7757/fanduck/assets/wechat-group-qr-20260922.png

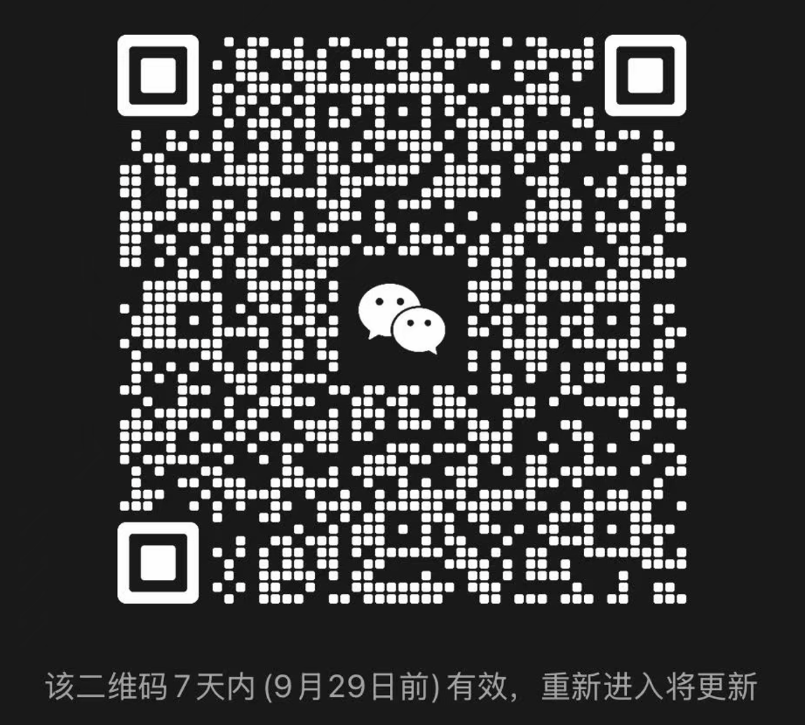
assets/wechat-group-qr-20260922.png
