7757/fanduck/hardware/dchub-v1.1/review/3D_bottom_iso.png

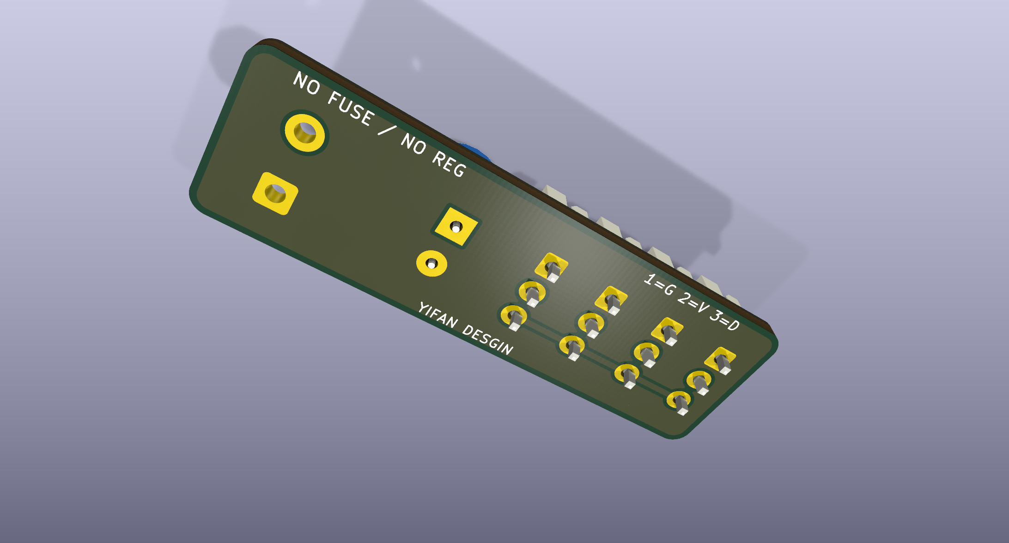
hardware/dchub-v1.1/review/3D_bottom_iso.png
