7757/fanduck/hardware/dchub-v1.1/review/3D_top_orthographic.png

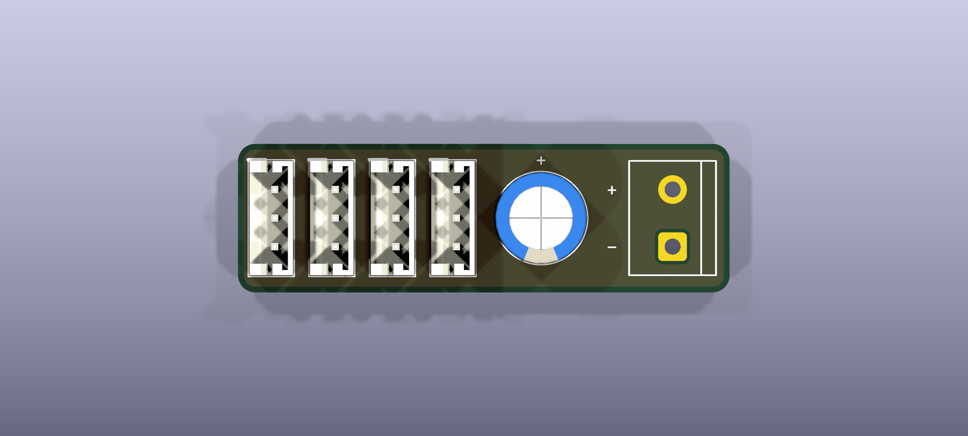
hardware/dchub-v1.1/review/3D_top_orthographic.png
