7757/fanduck/hardware/dchub-v1.1/source/BOM_manual_assembly.csv

References | Qty | Category | Manufacturer | MPN / specification | Value | Footprint | Assembly | Evidence status | Notes
J1,J2,J3,J4 | 4 | X3P connector | JST | B3B-EH-A(LF)(SN) | 3-pin EH, 2.50 mm | DCHUB:JST_EH_B3B-EH-A_1x03_P2.50mm_Vertical_Rot90 | Manual THT | Manufacturer confirmed | JST rates EH at 3 A AC/DC with AWG22; each installed branch still requires load verification.
J5 | 1 | Battery terminal | Generic / owner-specified | KF301-5.0-2P | 2-pin, 5.00 mm pitch | DCHUB:KF301-5.0-2P | Manual THT | Third-party / verify purchased part | Body <=7.6 x 10.0 mm, lead diameter <=1.3 mm. Verify exact supplier drawing before soldering.
C1 | 1 | Bulk capacitor | Panasonic | EEU-FR1C471 | 470 uF, 16 V, 105 C | DCHUB:CP_Radial_D8.0mm_P3.50mm_Vertical | Manual THT | Manufacturer confirmed | Polarized; 8.0 x 11.5 mm, P3.5 mm, FR low-impedance series.
