7757/fanduck/downloads/dchub-v1.1-20261030/fanduck-dchub-v1.1-schematic.pdf

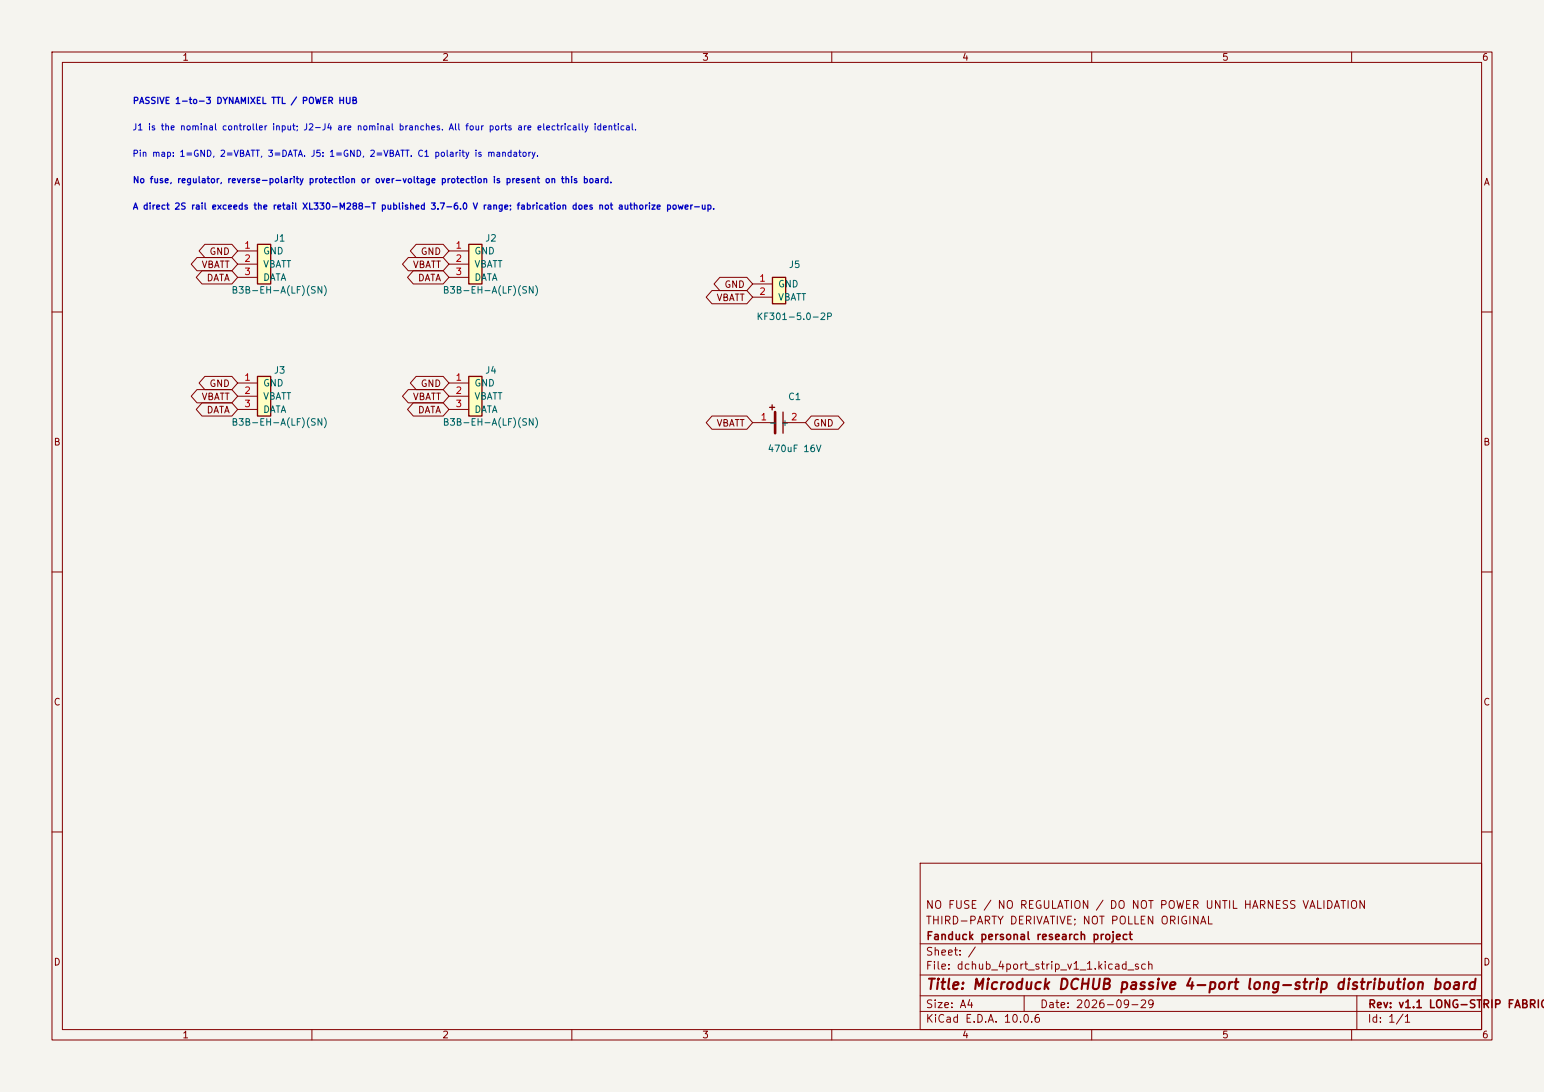
[picture p9: page 1]

VBATT PASSIVE 1-to-3 DYNAMIXEL TTL / POWER HUB

J1 is the nominal controller input; J2-J4 are nominal branches. All four ports are electrically identical. Pin map: 1=GND, 2=VBATT, 3=DATA. J5: 1=GND, 2=VBATT. C1 polarity is mandatory. No fuse, regulator, reverse-polarity protection or over-voltage protection is present on this board. A direct 2S rail exceeds the retail XL330-M288-T published 3.7-6.0 V range; fabrication does not authorize power-up.

J3 B3B-EH-A(LF)(SN) GND 1
VBATT DATA GND

J4 B3B-EH-A(LF)(SN) VBATT GND

NO FUSE / NO REGULATION / DO NOT POWER UNTIL HARNESS VALIDATION
THIRD-PARTY DERIVATIVE; NOT POLLEN ORIGINAL
Fanduck personal research project
Sheet: /
File: dchub_4port_strip_v1_1.kicad_sch
Title: Microduck DCHUB passive 4-port long-strip distribution board
KiCad E.D.A. 10.0.6
