7757/fanduck/hardware/dchub-v1.1/review/Drill_map.pdf

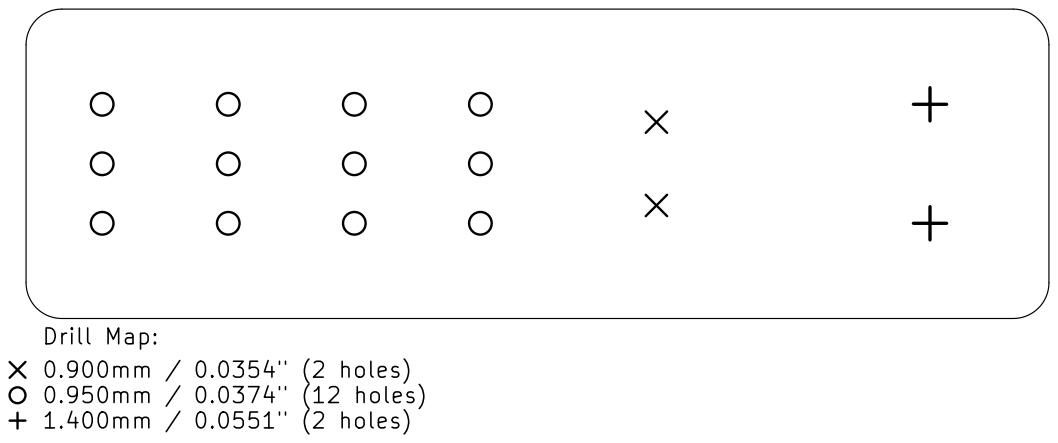
[picture p10: page 1]
