7757/fanduck/hardware/dchub-v1.1/review/PCB_bottom_mirrored.pdf

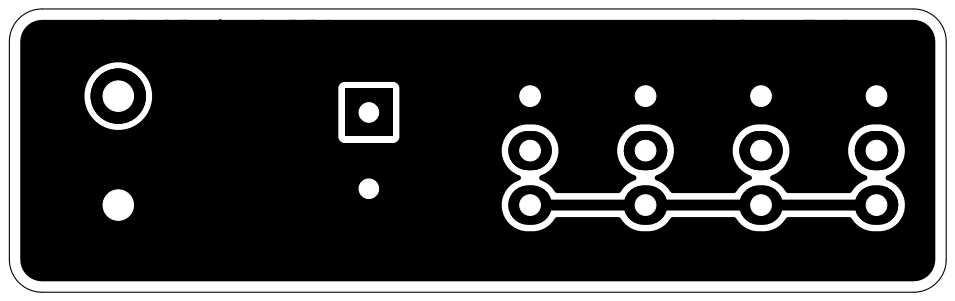
[picture p11: page 1]
