7757/fanduck/hardware/dchub-v1.1/review/PCB_top.pdf

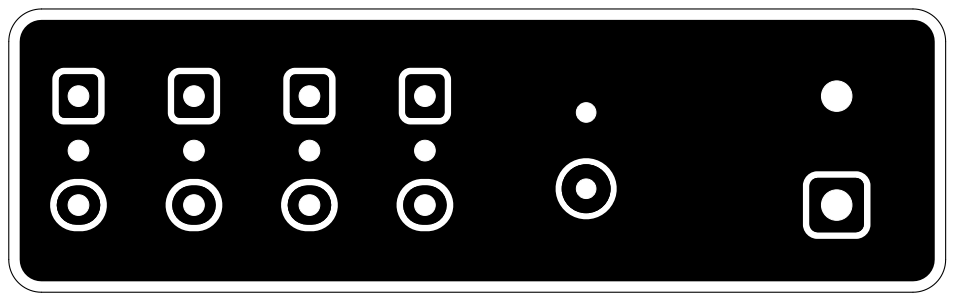
[picture p12: page 1]
