7757/fanduck/hardware/dchub-v1.1/source/dchub_4port_strip_v1_1.kicad_pcb

## KiCad design hardware/dchub-v1.1/source/dchub_4port_strip_v1_1.kicad_pcb (2026-10-30)

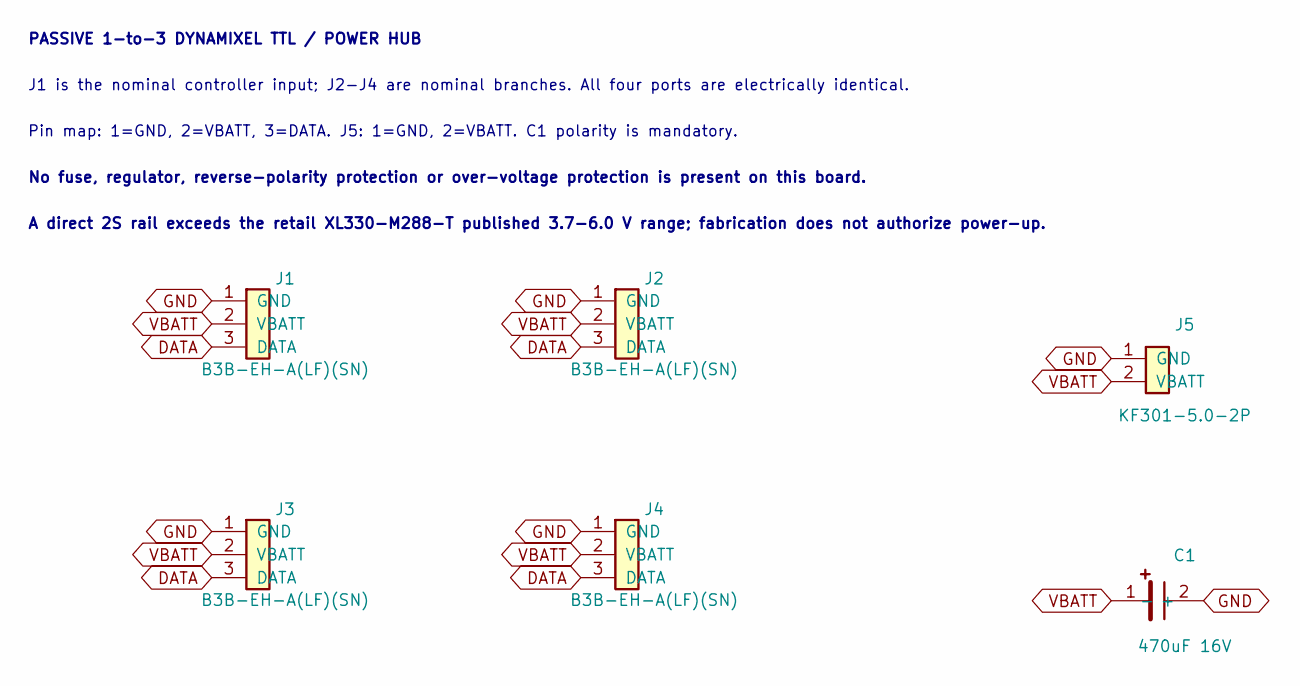
[picture p13: schematic dchub_4port_strip_v1_1.kicad_sch, Microduck DCHUB passive 4-port long-strip distribution board]

Parts:
C1: 470uF 16V; CP_Radial_D8.0mm_P3.50mm_Vertical
J1, J2, J3, J4: B3B-EH-A(LF)(SN); JST_EH_B3B-EH-A_1x03_P2.50mm_Vertical_Rot90
J5: KF301-5.0-2P

Connections:
DATA: J1.3 (DATA), J2.3 (DATA), J3.3 (DATA), J4.3 (DATA)
GND: C1.2 (-), J1.1 (GND), J2.1 (GND), J3.1 (GND), J4.1 (GND), J5.1 (GND)
VBATT: C1.1 (+), J1.2 (VBATT), J2.2 (VBATT), J3.2 (VBATT), J4.2 (VBATT), J5.2 (VBATT)

Notes on the sheet:
PASSIVE 1-to-3 DYNAMIXEL TTL / POWER HUB
J1 is the nominal controller input; J2-J4 are nominal branches. All four ports are electrically identical.
Pin map: 1=GND, 2=VBATT, 3=DATA. J5: 1=GND, 2=VBATT. C1 polarity is mandatory.
No fuse, regulator, reverse-polarity protection or over-voltage protection is present on this board.
A direct 2S rail exceeds the retail XL330-M288-T published 3.7-6.0 V range; fabrication does not authorize power-up.

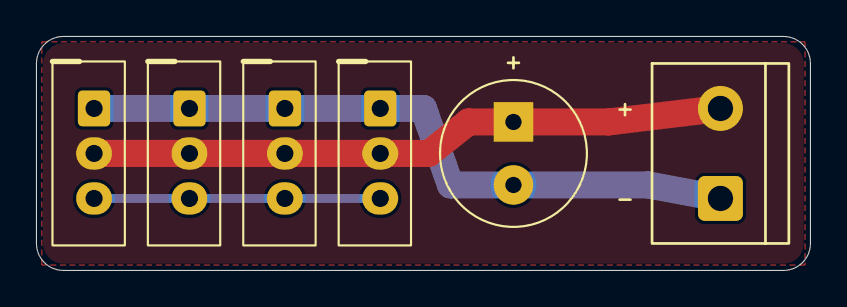
[picture p14: board dchub_4port_strip_v1_1.kicad_pcb from above]

Board: 2 copper layers, 43.0 x 13.0 mm, 6 parts (0 on the bottom side), 3 nets.
