7757/fanduck/hardware/dchub-v1.1/manufacturing/pcba/PCBA_ASSEMBLY_NOTES.md

# DCHUB 4P LONG v1.1 — 嘉立创 PCBA 插件装配说明

## 装配范围

- 仅顶层装配，共 6 个器件、16 个插件焊点／片。
- J1–J4：原厂 JST `B3B-EH-A(LF)(SN)`，嘉立创编号 `C160259`，每片 4 个。
- J5：KEFA `KF301-5.0-2P`，嘉立创编号 `C474881`，每片 1 个。
- C1：Rubycon `16ZLH470MEFC8X11.5`，470 uF / 16 V，嘉立创编号 `C109066`，每片 1 个。

## 方向要求

1. J1–J4 必须同向安装，不得任意旋转 180°。1 脚对准 PCB 方形焊盘；从板顶边到板底边依次为 1=GND、2=VBATT、3=DATA。
2. C1 是有极性电解电容。正极安装到 C1.1 方形焊盘以及 PCB `+` 丝印一侧；负极安装到 C1.2 与 `-` 丝印一侧。反装不得出货。
3. J5 的 2 脚为 VBATT 正极，位于 PCB `+` 丝印一侧；1 脚为 GND，位于 `-` 丝印一侧。接线开口朝向 PCB 右侧外边缘。
4. 所有器件必须贴紧 PCB、保持竖直；J1–J4 的塑壳底面高度和方向应一致。

## 文件说明

- `JLCPCB_BOM_DCHUB_4P_LONG_v1.1.csv`：带列名的完整 BOM，已固定嘉立创器件编号。
- `JLCPCB_BOM_UPLOAD_DCHUB_4P_LONG_v1.1.csv`：嘉立创网页实际上传版。当前“AD、99SE、Allegro、PADS 等其他”解析器会把普通 CSV 列名误当成一个器件，因此该文件按平台实际解析行为去掉列名，只保留三行有效物料。
- `JLCPCB_CPL_DCHUB_4P_LONG_v1.1.csv`：器件中心坐标。自定义 KiCad 封装原点不在实体中心，因此本文件使用校正后的实体中心坐标，不应改回 KiCad 原始导出的焊盘原点。J1–J5 以及 C1 的 90° 方向均已根据嘉立创 2D 装配预览核对；C1 的正极必须朝 PCB `+` 丝印一侧，不能改回 0°。
- 装配预览必须确认所有 6 个器件都在顶层，且 C1 正负极、J5 正负极及四个 JST 插座方向与本说明一致。

## 变更说明

原 BOM 的 Panasonic `EEU-FR1C471` 在嘉立创当前可贴库存对应型号为 5.0 mm 脚距，和本 PCB 的 3.5 mm 孔距不兼容。本 PCBA BOM 改用同为 470 uF / 16 V、直径 8 mm、3.5 mm 脚距的 Rubycon `16ZLH470MEFC8X11.5`。这是为适配已下单 PCB 孔距所做的替代件选择，不是 Pollen 官方 1:1 配置。
