7757/fanduck/(commit log)

2026-09-16 Publish Fanduck Microduck build materials and demos
2026-10-30 docs: publish DCHUB v1.1 designs and online parts list
    [BOM_manual_assembly.csv, JLCPCB_BOM_DCHUB_4P_LONG_v1.1.csv, JLCPCB_BOM_UPLOAD_DCHUB_4P_LONG_v1.1.csv, NETLIST_and_pinmap.csv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]
2026-10-30 fix: preserve original DCHUB CSV bytes for checksum verification
    [BOM_manual_assembly.csv, NETLIST_and_pinmap.csv]
